ableda/OccuSense/Arduino/Schematic.png

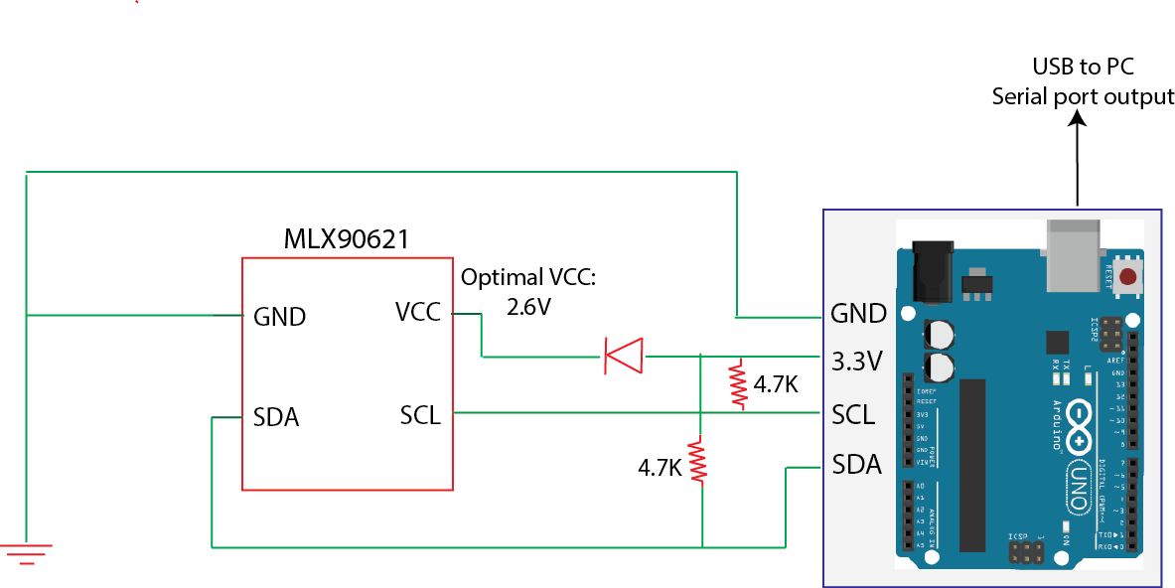
Arduino/Schematic.png
