ableda/OccuSense/Raspberry_Pi/PIR_schematic.png

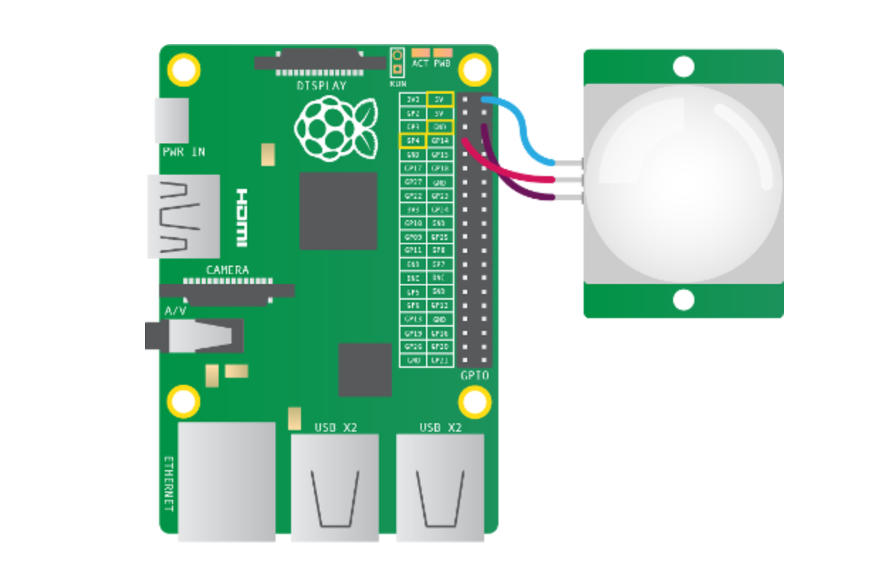
Raspberry_Pi/PIR_schematic.png
