ableda/OccuSense/System_block_diagram.png

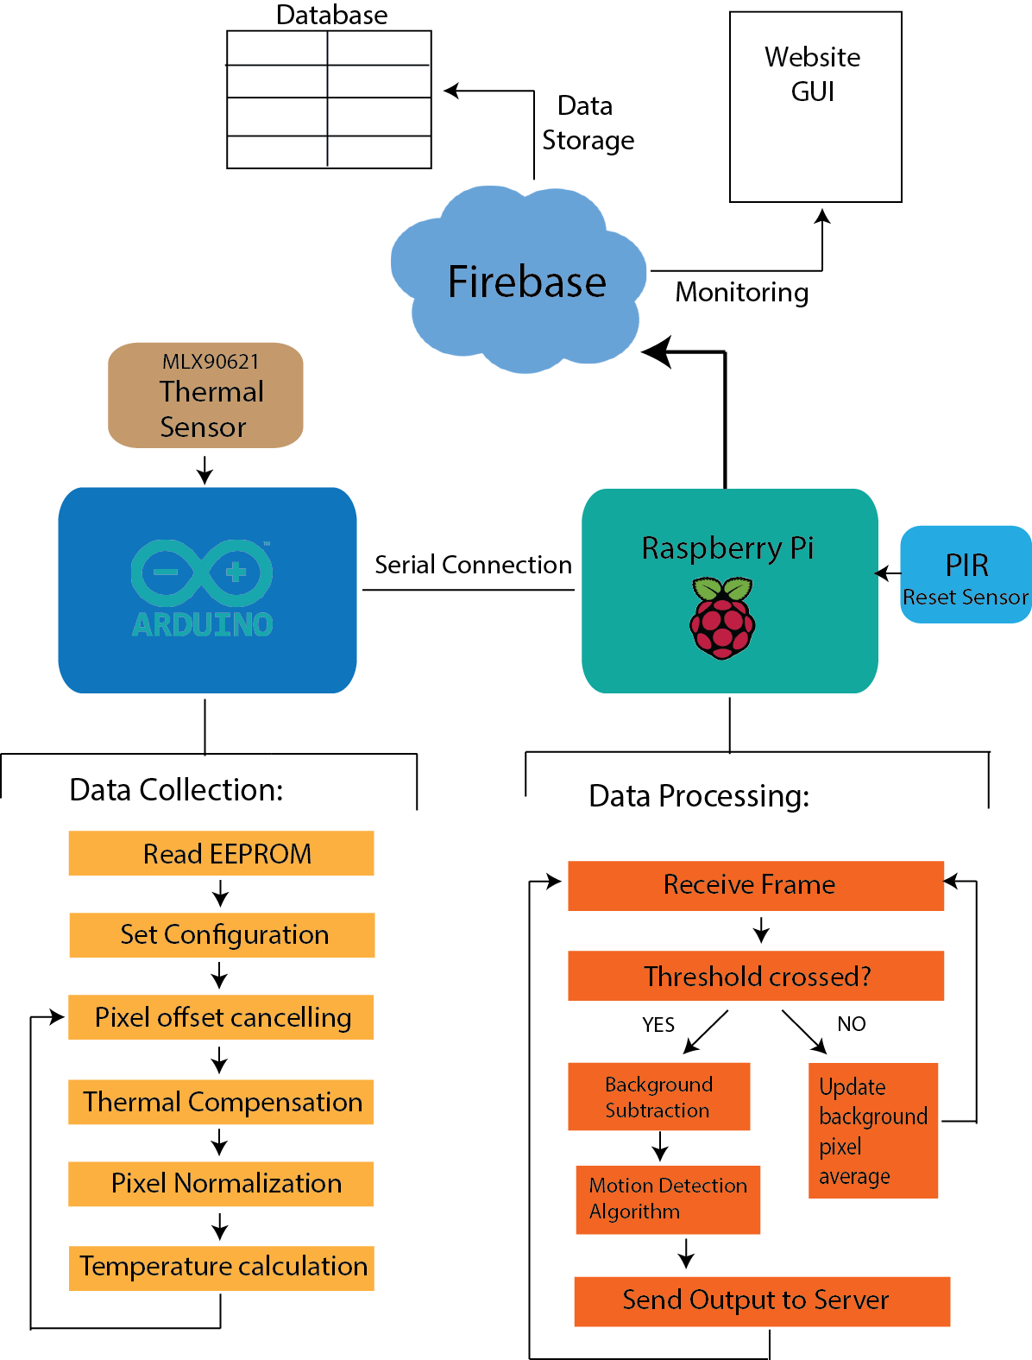
System_block_diagram.png
