ableda/OccuSense/(commit log)

2017-04-30 raspberry code
2017-05-02 raspberry format
